ppknkn/RoboBachelor/media/README.en.md

[简体中文](README.md) | [English](README.en.md)

# Prototype and demonstration media

This directory collects SparkR / RoboBachelor prototype photos, leg-mechanism illustrations and motion footage for use in project pages and documentation.

The RoboBachelor prototype with its side gears, links and control electronics.

| File | Content |
| --- | --- |
| [robobachelor-prototype.webp](robobachelor-prototype.webp) | Full prototype photo |
| [leg-mechanism.png](leg-mechanism.png) | Single-leg mechanism and geometry |
| [indoor-motion.webp](indoor-motion.webp) | Indoor motion frame |
| [outdoor-motion.webp](outdoor-motion.webp) | Outdoor wooden-deck motion frame |
| [robobachelor-motion.gif](robobachelor-motion.gif) | Short animated preview for Markdown |
| [robobachelor-motion.mp4](robobachelor-motion.mp4) | Full 26-second demonstration, no audio |

[Download the full MP4](https://github.com/ppknkn/RoboBachelor/raw/refs/heads/main/media/robobachelor-motion.mp4). README pages use the GIF for an inline preview and the MP4 link for the full video download.

The media comes from this project's existing SparkR website and mechanism documentation. See the [media source record](../docs/media-sources.md) for provenance and version context, and the [license guide](../LICENSE.md) for terms and attribution.

[Back to the project overview](../README.en.md)
