ppknkn/RoboBachelor/media/README.md

[简体中文](README.md) | [English](README.en.md)

# 实物与演示媒体

本目录汇集 SparkR / RoboBachelor 的实物照片、腿部机构图和运动演示，供项目介绍与文档引用。

RoboBachelor 实物样机及其侧面齿轮、连杆和机身板卡。

| 文件 | 内容 |
| --- | --- |
| [robobachelor-prototype.webp](robobachelor-prototype.webp) | 整机实物照片 |
| [leg-mechanism.png](leg-mechanism.png) | 单侧腿机构与几何图 |
| [indoor-motion.webp](indoor-motion.webp) | 室内运动画面 |
| [outdoor-motion.webp](outdoor-motion.webp) | 室外木质地面运动画面 |
| [robobachelor-motion.gif](robobachelor-motion.gif) | 可直接嵌入 Markdown 的短动图 |
| [robobachelor-motion.mp4](robobachelor-motion.mp4) | 26 秒完整演示，无音轨 |

[下载完整 MP4](https://github.com/ppknkn/RoboBachelor/raw/refs/heads/main/media/robobachelor-motion.mp4)。README 使用 GIF 直接预览，MP4 链接用于下载完整视频。

媒体来自本项目已有的 SparkR 网站与机构资料。详细来源和版本对应关系见[媒体来源记录](../docs/media-sources.md)；许可与署名从[统一许可说明](../LICENSE.md)查阅。

[返回项目介绍](../README.md)
