ppknkn/RoboBachelor/docs/mechanical-notes.md

# 机械模型使用与检查说明

模型入口与部件表见 [mechanical/README.md](../mechanical/README.md)。这里集中说明装配、文件格式和制造资料的边界。

## 原生格式与装配引用

仓库提供 2 个 SLDASM 与 9 个 SLDPRT，保持既有文件名和平铺位置。当前未提供 STEP、STL、Parasolid、工程图或 URDF。`native-manifest.json` 记录文件大小与哈希；CAD 文档单位应在实际打开时确认。

先在支持文件保存版本的 SolidWorks 中打开总装。若缺少外部引用，在 CAD 的引用管理中定位对应文件，使用 Pack and Go 整理修改副本；不要在文件管理器中直接改零件名称或十六进制替换内部路径。另存或导出后需重新核对装配引用、单位、几何与版本兼容性。

## 检查与制造资料

现有模型尚未完成 CAD 打开、重建、干涉和内部依赖验证；专有压缩属性中的作者、公司与嵌入路径也需要通过 CAD 属性工具检查。二进制哈希相同只用于传输完整性核对。

制造前应补充或确认材料、关键尺寸、公差、紧固件、装配顺序和机械限位，不从文件名推测。若提供可交换格式，应由原生 CAD 导出并复核；本仓库不把未经检查的导出称为可制造资料。

## 许可入口

文件授权范围、外部模型来源与原通知统一见 [LICENSE.md](../LICENSE.md)。原创硬件的完整源要求应结合随附 CERN-OHL-S-2.0 原文核对，尤其是专有原生格式的可查看替代形式；现有模型文件不等于已验证的完整制造包。这里的说明不改变许可证或第三方权利。
