ppknkn/RoboBachelor/docs/media-sources.md

# 媒体来源记录

浏览入口见 [media/README.md](../media/README.md)。媒体来自项目既有 SparkR 网站和机构资料；原始照片、视频及文档保持原样。

| 发布文件 | 来源与处理 |
| --- | --- |
| robobachelor-prototype.webp | sparkr-built.webp 实物照片；保持画面，重编码 |
| leg-mechanism.png | sparkr-leg-kinematics.png；保留原图 |
| indoor-motion.webp / outdoor-motion.webp | 既有无音轨视频第1秒 / 第18秒，裁剪与压缩 |
| robobachelor-motion.gif | 同一视频第1–3秒及第16–18秒，裁剪、缩放与降低帧率/色数 |
| robobachelor-motion.mp4 | 既有26秒H.264视频，保留画面、去音轨和附加元数据后重封装 |

影像对应项目既有样机，硬件有过迭代；发布工程配置见硬件说明，当前固件验证范围见 [validation.md](validation.md)。它们不作为新 IMU 后端的真机测试证据。

交龙战队资料作为构型思路参考链接，不在本媒体目录打包其照片、图纸或技术文档。具体文件许可与署名入口为 [LICENSE.md](../LICENSE.md)。
