ppknkn/RoboBachelor/docs/control.md

# PID 架构与参数

本版本按实际调用路径说明，所有列出的数值来自本次整理时的源码；没有重新调参。

| 环节 | 位置 | 实现和默认值 |
| --- | --- | --- |
| 位置保持 PI | `state_estimator.c` | Kp=0.4，Ki=0.02；积分项限制 ±2.0 m/s，输出限制 ±0.5 m/s |
| 轮速低通 | `balance_ctrl.c` | `filtered_v = 0.7 * previous + 0.3 * average` |
| 速度 P | `balance_ctrl.h/.c` | Kp=0.15 rad·s/m；输出倾角限制 ±0.25 rad |
| 直立 PD | 同上 | Kp=200，Kd=10，theta_offset=0；`F=Kp*(theta-theta_total)+Kd*dtheta`，F 是控制中间量，不据此宣称实测支撑力 |
| 轮力矩换算 | 同上 | wheel_kf=0.012，直立分量及最终左右轮限制 ±0.48 N·m |
| 偏航速度 P | 同上 | Kp=0.30，差速力矩分量限制 ±0.25 N·m；保留原符号 |
| 腿部位置目标 | 同上 | `leg_ik(target_leg_len, 0)`，平衡时 MIT kp=20、kd=1 |
| 起身 | 同上及 `main.c` | 速度按误差比例分配，最大 3.2 rad/s，到位阈值 0.05 rad；MIT kp=0、kd=2 |
| 跌倒检测 | `main.c` | 保留原1rad停机锁存；新IMU无效也沿同一路径停机，无ARM流程 |

`LEG_L_REF=107` 是保留的历史宏，当前遥控腿长中心是 `IDEAL_LEG_L=102.5 mm`；不要把未使用宏当作实际目标。

## 状态与遥控

枚举值ESTOP=0、BALANCE=1、DRIVE=2、STANDUP=3。恢复原 `sw1==0 → ESTOP`、其他值走STANDUP/BALANCE/DRIVE流程；真实物理拨杆解析尚未核实。启动沿原路径请求使能，无新增解锁或遥控超时。STOP时不发新关节目标、轮零力矩，见[safety.md](safety.md)。

DRIVE 模式中 CH0 映射目标线速度，公式为 `-(ch[0]/700)*1.5 m/s`；CH1 映射 `-(ch[1]/700)*5 rad/s`；CH2 调节目标腿长并限制在 88.5–122.5 mm。CH0 绝对值小于 15 时启用位置保持。这些是输入缩放和代码限幅，不是验证过的机器人速度或机械能力。

## 单位与名义节拍

腿部长度、运动学几何为 mm；关节位置为 rad；角速度为 rad/s；轮速反馈先由 rpm 转为 m/s；编码器位置由 deg 积累为 m；力矩命令采用 N·m 协议缩放。姿态直接使用 `imu.rol` 作为直立角，安装方向必须符合原约定。

主循环在距离上次控制段结束至少 2 ms 后进入控制段，估计器 dt 限制为 1–5 ms。每段只轮询发送一个关节和一个轮子的命令，因此理想情况下每个关节约 8 ms、每个轮约 4 ms 才收到一次该路径命令。串口阻塞和其他耗时会进一步拉长周期；没有硬实时或实测 500 Hz 保证。

UART8 支持 `BKP=`, `BKD=`, `VKP=`, `TKP=`, `TOF=`，数据写入 RAM 参数；不写 Flash。`VKI=`, `PKP=`, `PKI=` 当前不支持。调参仅在原STOP的ESTOP状态处理，拒绝 NaN/无限值和畸形数字，使用有界回复；未声称所有有限参数都对实物安全。
