ppknkn/RoboBachelor/mechanical/DM-MIT-NOTICE.md

# DM 电机模型来源与许可

适用文件：[native/DM-J4310-2EC-V1.1_3d_20260228_1.SLDPRT](native/DM-J4310-2EC-V1.1_3d_20260228_1.SLDPRT)。

项目作者已向达妙官方确认该模型采用 **MIT**。这份授权信息来自作者与厂家的直接确认；本仓库未附厂家另行提供的原始版权通知。模型保留原文件和其中的声明，不适用原创机械的 CERN-OHL-S-2.0 授权。

[MIT 标准条款副本](../LICENSES/MIT.txt)中的 `<year>` 与 `<copyright holders>` 是模板占位符，不是本项目为厂家填写的署名。取得厂家原始通知时，应原样随模型保留，不推测权利人或年份。

厂家资料入口：[dmBots](https://github.com/dmBots/dmBot)。统一许可范围见 [LICENSE.md](../LICENSE.md)。
