ppknkn/RoboBachelor/mechanical/excluded-models.md

# 模型清单入口

当前 `native/` 提供 11 个模型文件，没有额外排除的模型。完整文件表与装配入口见[机械模型导航](README.md)，逐文件许可范围从[统一许可说明](../LICENSE.md)查阅。
