ppknkn/RoboBachelor/mechanical/native/串联右腿260406-tiny.SLDASM

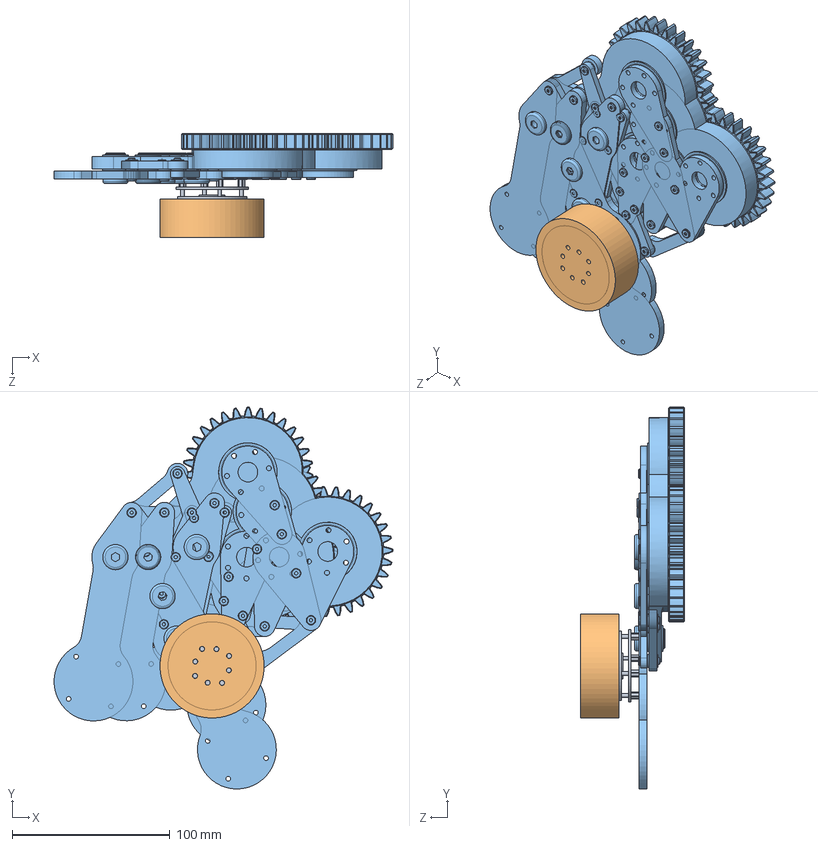
[picture p6: CAD file, 2026-10-23]
mechanical/native/串联右腿260406-tiny.SLDASM
214.6 x 242.0 x 65.9 mm
串联腿_260406-tiny x 6
轮
JC4310尺寸
