ppknkn/RoboBachelor/mechanical/native/!总装_tiny.SLDASM

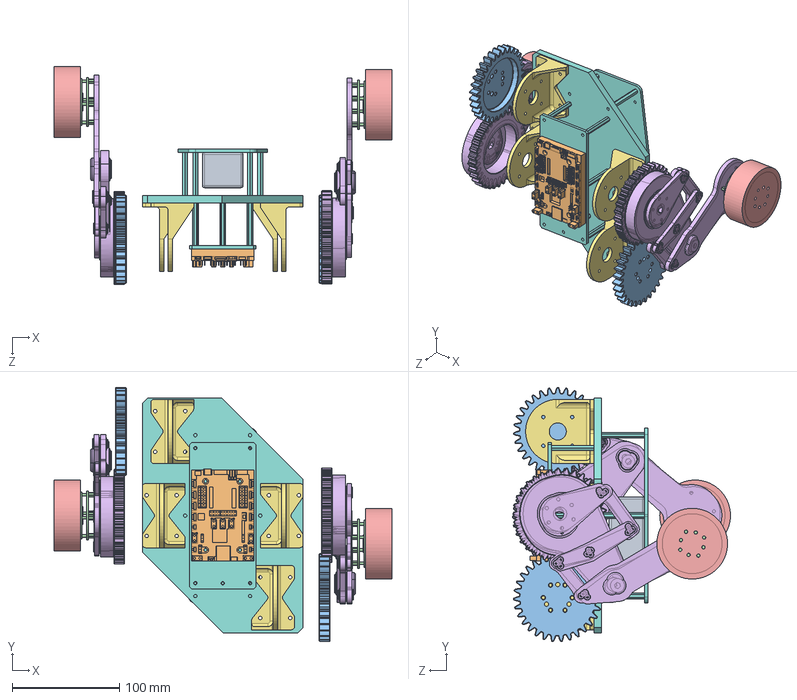
[picture p7: CAD file, 2026-10-23]
mechanical/native/!总装_tiny.SLDASM
315.3 x 237.4 x 203.3 mm
车架260412_tiny
电机架260412_tiny x 4
串联腿_260406-tiny x 12
轮 x 2
JC4310尺寸 x 2
主动齿轮_tiny x 2
Robomaster_A_board
rline1050
