ppknkn/RoboBachelor/mechanical/native/Robomaster_A_board.SLDPRT

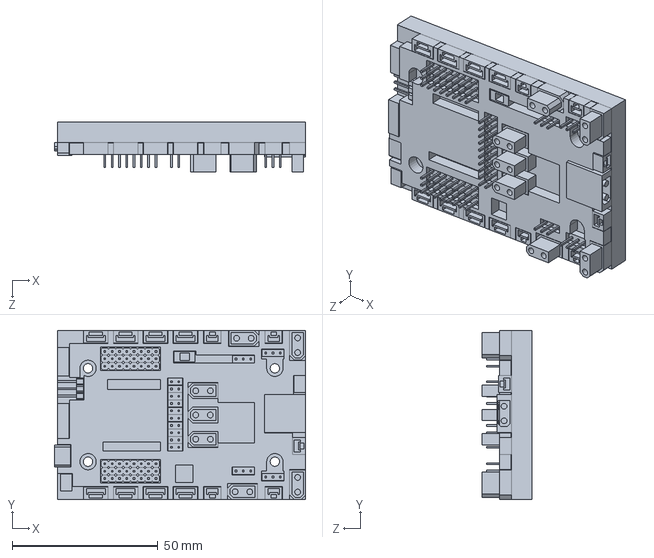
[picture p8: CAD file, 2026-10-23]
mechanical/native/Robomaster_A_board.SLDPRT
86.0 x 58.0 x 17.0 mm
