ppknkn/RoboBachelor/mechanical/native/rline1050.SLDPRT

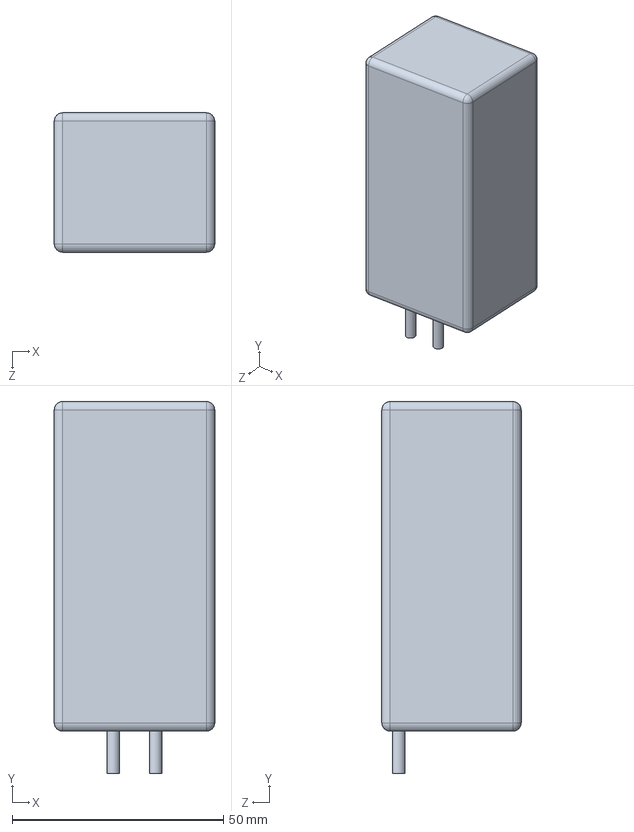
[picture p9: CAD file, 2026-10-23]
mechanical/native/rline1050.SLDPRT
38.0 x 88.0 x 33.0 mm
