ppknkn/RoboBachelor/mechanical/native/串联腿_260406-tiny.SLDPRT

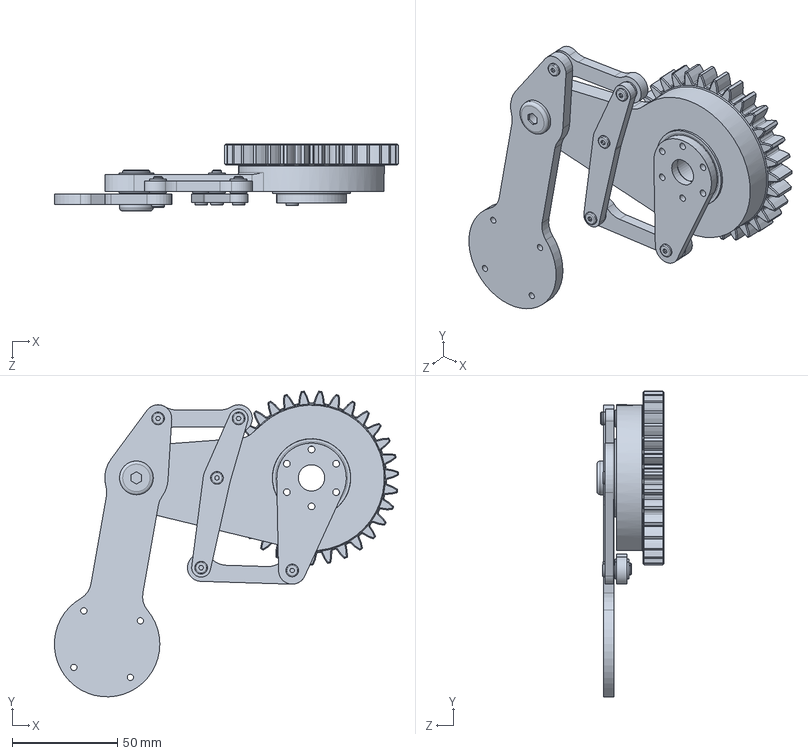
[picture p10: CAD file, 2026-10-23]
mechanical/native/串联腿_260406-tiny.SLDPRT
163.1 x 144.9 x 31.8 mm
