ppknkn/RoboBachelor/mechanical/native/DM-J4310-2EC-V1.1_3d_20260228_1.SLDPRT

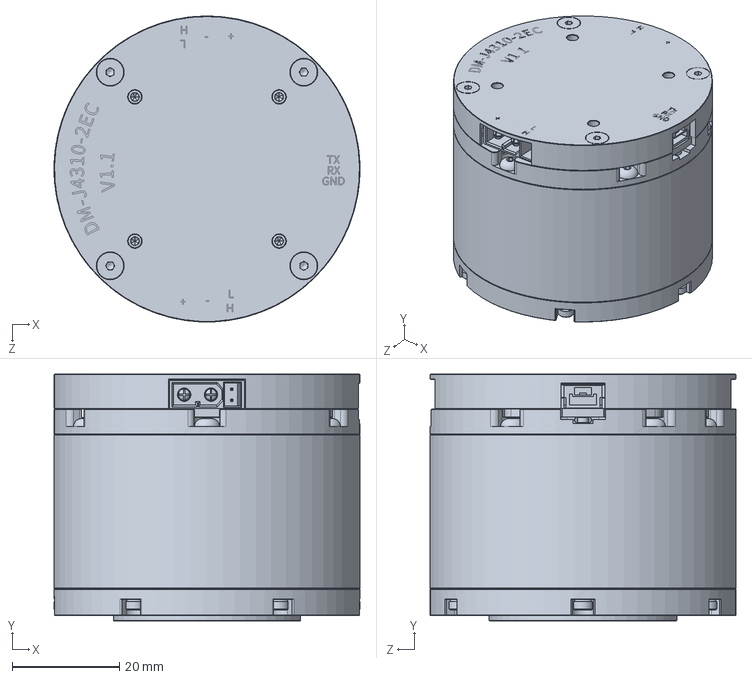
[picture p11: CAD file, 2026-10-23]
mechanical/native/DM-J4310-2EC-V1.1_3d_20260228_1.SLDPRT
57.0 x 46.0 x 57.0 mm
