ppknkn/RoboBachelor/mechanical/native/JC4310尺寸.SLDPRT

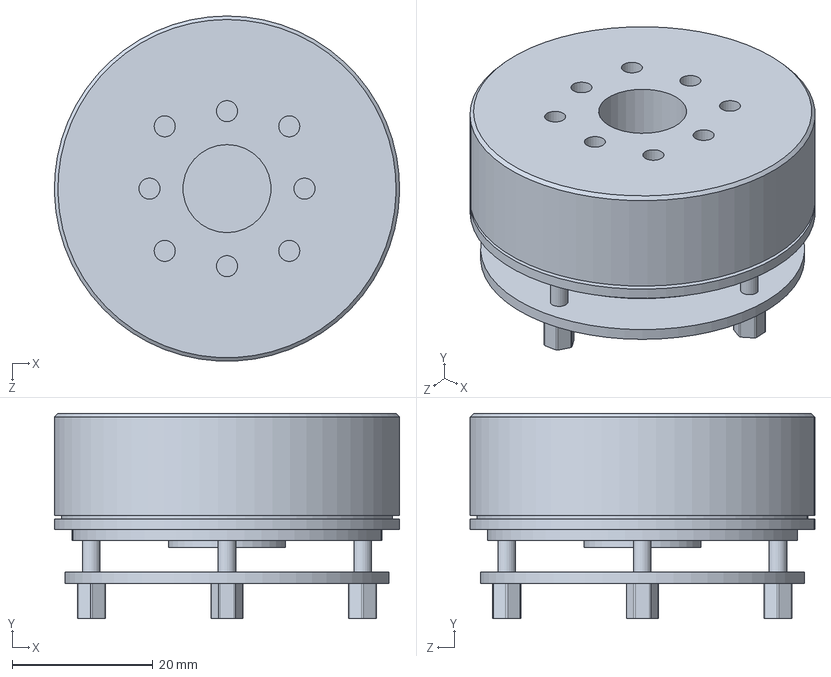
[picture p12: CAD file, 2026-10-23]
mechanical/native/JC4310尺寸.SLDPRT
49.0 x 29.1 x 49.0 mm
