ppknkn/RoboBachelor/mechanical/native/主动齿轮_tiny.SLDPRT

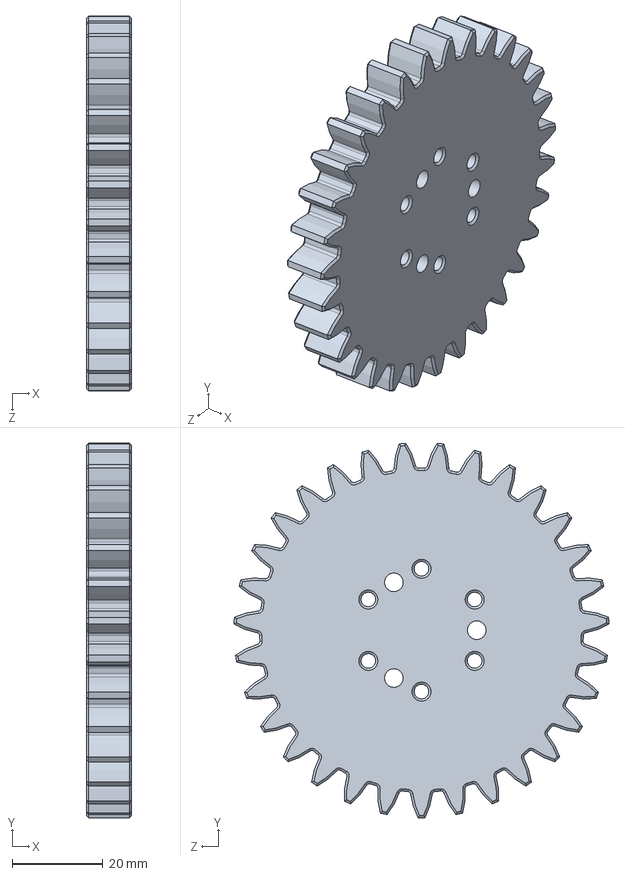
[picture p13: CAD file, 2026-10-23]
mechanical/native/主动齿轮_tiny.SLDPRT
10.0 x 82.4 x 82.5 mm
