ppknkn/RoboBachelor/mechanical/native/车架260412_tiny.SLDPRT

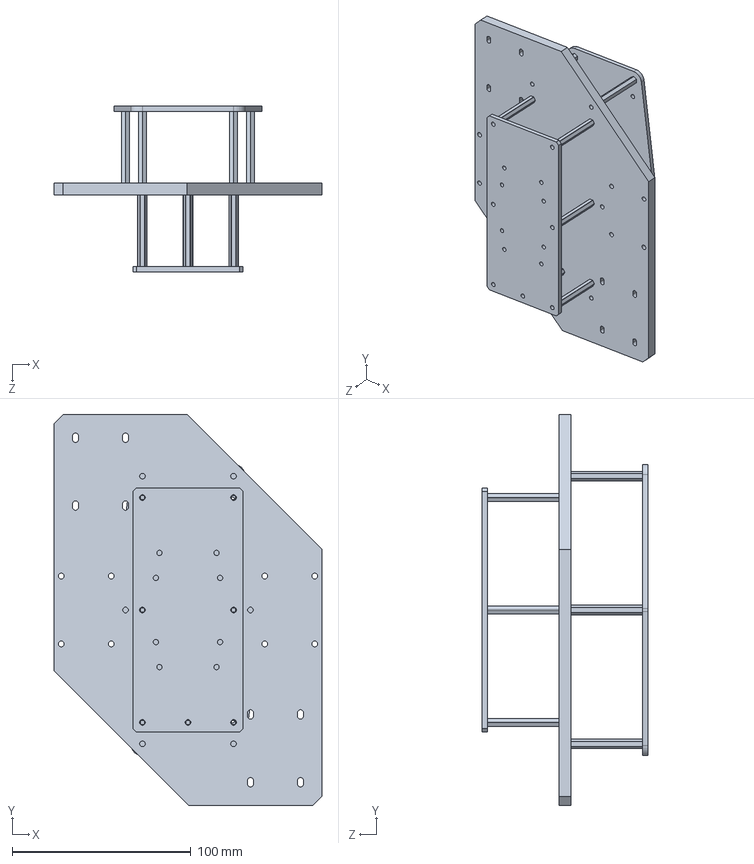
[picture p14: CAD file, 2026-10-23]
mechanical/native/车架260412_tiny.SLDPRT
150.0 x 219.0 x 93.0 mm
