ppknkn/RoboBachelor/mechanical/native/电机架260412_tiny.SLDPRT

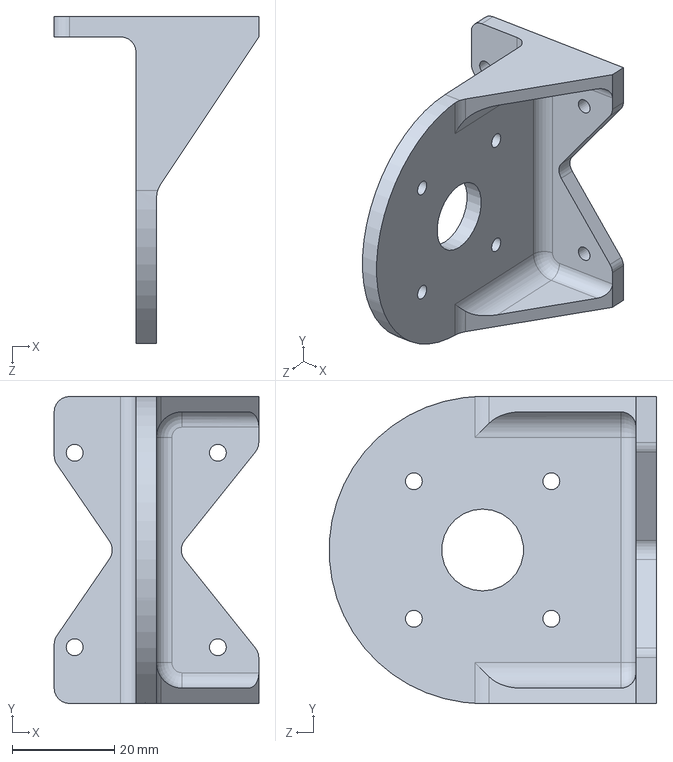
[picture p15: CAD file, 2026-10-23]
mechanical/native/电机架260412_tiny.SLDPRT
40.0 x 60.0 x 63.9 mm
