ppknkn/RoboBachelor/mechanical/native/轮.SLDPRT

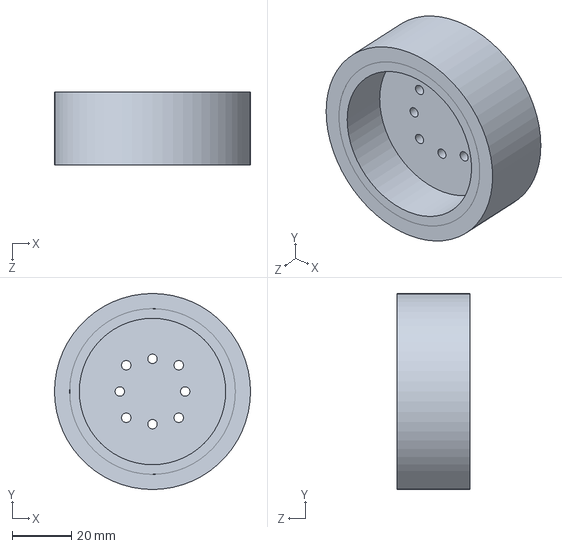
[picture p16: CAD file, 2026-10-23]
mechanical/native/轮.SLDPRT
66.0 x 66.0 x 24.5 mm
