ppknkn/RoboBachelor/CHANGELOG.md

# 变更记录

## 完整源码开源版 — 2026-10-23

- 使用项目名RoboBachelor；代码/模型分目录，保留Keil内部路径及11个原生模型的原名/二进制。原完整项目与迁移前候选已在本地分阶段归档，公共仓库无原私有历史、凭据、IDE配置及编译产物。
- 旧无明确许可的A板IMU及其辅助头/代码移出分发；实际采用MIT LibDriver raw/AUX子集和GPL C板Mahony源码，新增SPI/AUX、校准和兼容接口，全部所需源码随附。明确记录数值/时序差异，硬件未验证。
- 按作者最终要求恢复原启动使能与STOP拨杆路径；撤回新增ARM/DISARM、遥控超时状态机和永久禁能宏；不猜接收机模式、不替换原解析映射。HOLD无线失联限制保留在文档。
- 保留STOP输出缺陷修复：抑制新关节目标、轮零力矩、清速度/转向/位置保持缓存。STOP不等于卸力。原倾角停机路径保留，新IMU初始化失败阻止后续使能，运行无效状态进入同一故障停机路径。
- 保留JC动作值1的协议纠正、起身首帧分支修复、无效几何phi初始化、300ms打印计时、有界主循环调参及非有限输入拒绝。正常PID/PI默认值、控制计算、运动学参数、CAN映射/符号和单位未重新调参。
- 去除未调用VMC/LQR实验文件、未使用示例与重复注释代码；补类型声明、math包含、头文件内联边界与真实单位注释，禁用空post-build槽。
- 新增真实IMU栈/端口/原STOP/电机协议及离线帧测试；Keil完整编译链接38C，0错误/0警告，GCC C检查38C，0失败/0警告。没有刷写、实物性能或CAD验证结论。
