ppknkn/RoboBachelor/firmware/Inc/main.h

#define LED_RED_Pin GPIO_PIN_11
#define LED_RED_GPIO_Port GPIOE
#define LED_GREEN_Pin GPIO_PIN_14
#define LED_GREEN_GPIO_Port GPIOF
