ppknkn/RoboBachelor/(commit log)

2026-10-23 Prepare RoboBachelor PID firmware and mechanical source release
2026-10-23 Introduce the robot with mechanism diagrams and real prototype media
